MissouriMRDT/PowerManagement_Hardware/Docs/PMS Current Distrubution Diagram.png

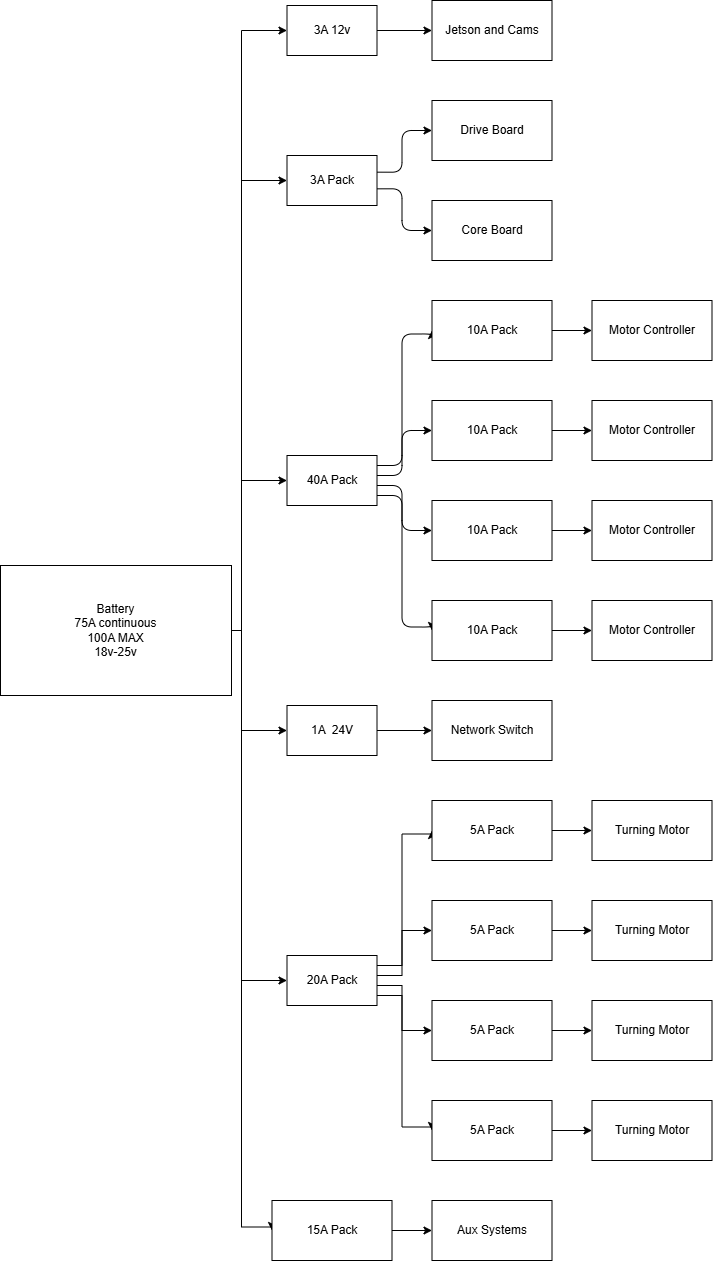
Docs/PMS Current Distrubution Diagram.png
