MissouriMRDT/PowerManagement_Hardware/PMS_board/PMS_board.kicad_pcb

## KiCad design PMS_board/PMS_board.kicad_pcb (2026-11-13)

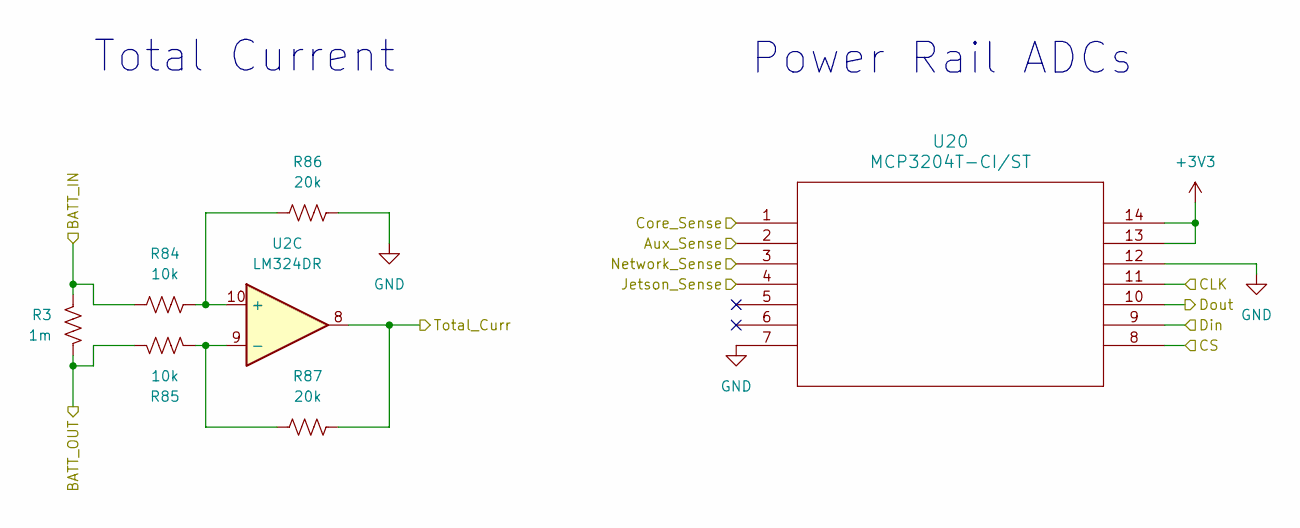
[picture p2: schematic CurrentSensing.kicad_sch]

Parts:
R3: 1m; ShuntSMD_BVT-M-R001-1.0
R84, R85: 10k; R_0603_1608Metric_Pad0.98x0.95mm_HandSolder
R86, R87: 20k; R_0603_1608Metric_Pad0.98x0.95mm_HandSolder
U2: LM324DR; SOIC-14_3.9x8.7mm_P1.27mm
U20: MCP3204T-CI/ST; TSSOP14_MC_MCH

Connections:
+3V3: U20.13, U20.14; also elsewhere on the board
/Current Sensing/Aux_Sense: U20.2; also elsewhere on the board
/Current Sensing/BATT_OUT: R3.2, R85.1; also elsewhere on the board
/Current Sensing/CLK: U20.11; also elsewhere on the board
/Current Sensing/CS: U20.8; also elsewhere on the board
/Current Sensing/Core_Sense: U20.1; also elsewhere on the board
/Current Sensing/Din: U20.9; also elsewhere on the board
/Current Sensing/Dout: U20.10; also elsewhere on the board
/Current Sensing/Jetson_Sense: U20.4; also elsewhere on the board
/Current Sensing/Network_Sense: U20.3; also elsewhere on the board
/Current Sensing/Total_Curr: R87.2, U2.8; also elsewhere on the board
/HotSwap/Aalmout: R3.1, R84.1; also elsewhere on the board
GND: R86.2, U20.7, U20.12; also elsewhere on the board
unnamed: R84.2, R86.1, U2.10 (+)
unnamed: R85.2, R87.1, U2.9 (-)

Notes on the sheet:
Total Current
Power Rail ADCs

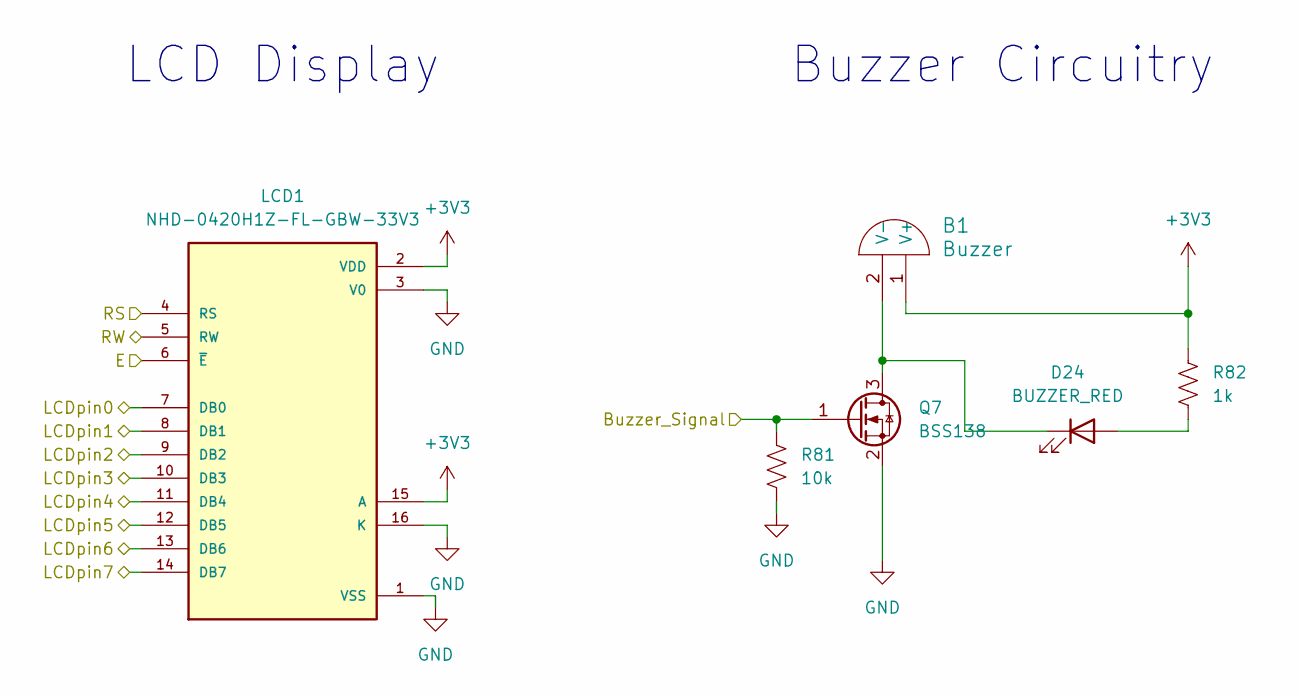
[picture p3: schematic Display.kicad_sch]

Parts:
B1: Buzzer; Buzzer_12x9.5RM7.6
D24: BUZZER_RED; LED_0603_1608Metric_Pad1.05x0.95mm_HandSolder
LCD1: NHD-0420H1Z-FL-GBW-33V3; LCD_NHD-0420H1Z-FL-GBW-33V3; PARTREV 02
Q7: BSS138; SOT-23
R81: 10k; R_0603_1608Metric_Pad0.98x0.95mm_HandSolder
R82: 1k; R_0603_1608Metric_Pad0.98x0.95mm_HandSolder

Connections:
+3V3: B1.1 (V+), LCD1.2 (VDD), LCD1.15 (A), R82.1; also elsewhere on the board
/Battery Display/Buzzer_Signal: Q7.1 (G), R81.1; also elsewhere on the board
/Battery Display/E: LCD1.6 (~E); also elsewhere on the board
/Battery Display/LCDpin0: LCD1.7 (DB0); also elsewhere on the board
/Battery Display/LCDpin1: LCD1.8 (DB1); also elsewhere on the board
/Battery Display/LCDpin2: LCD1.9 (DB2); also elsewhere on the board
/Battery Display/LCDpin3: LCD1.10 (DB3); also elsewhere on the board
/Battery Display/LCDpin4: LCD1.11 (DB4); also elsewhere on the board
/Battery Display/LCDpin5: LCD1.12 (DB5); also elsewhere on the board
/Battery Display/LCDpin6: LCD1.13 (DB6); also elsewhere on the board
/Battery Display/LCDpin7: LCD1.14 (DB7); also elsewhere on the board
/Battery Display/RS: LCD1.4 (RS); also elsewhere on the board
/Battery Display/RW: LCD1.5 (RW); also elsewhere on the board
GND: LCD1.1 (VSS), LCD1.3 (V0), LCD1.16 (K), Q7.2 (S), R81.2; also elsewhere on the board
unnamed: B1.2 (V-), D24.1 (K), Q7.3 (D)
unnamed: D24.2 (A), R82.2

Notes on the sheet:
Buzzer Circuitry
LCD Display

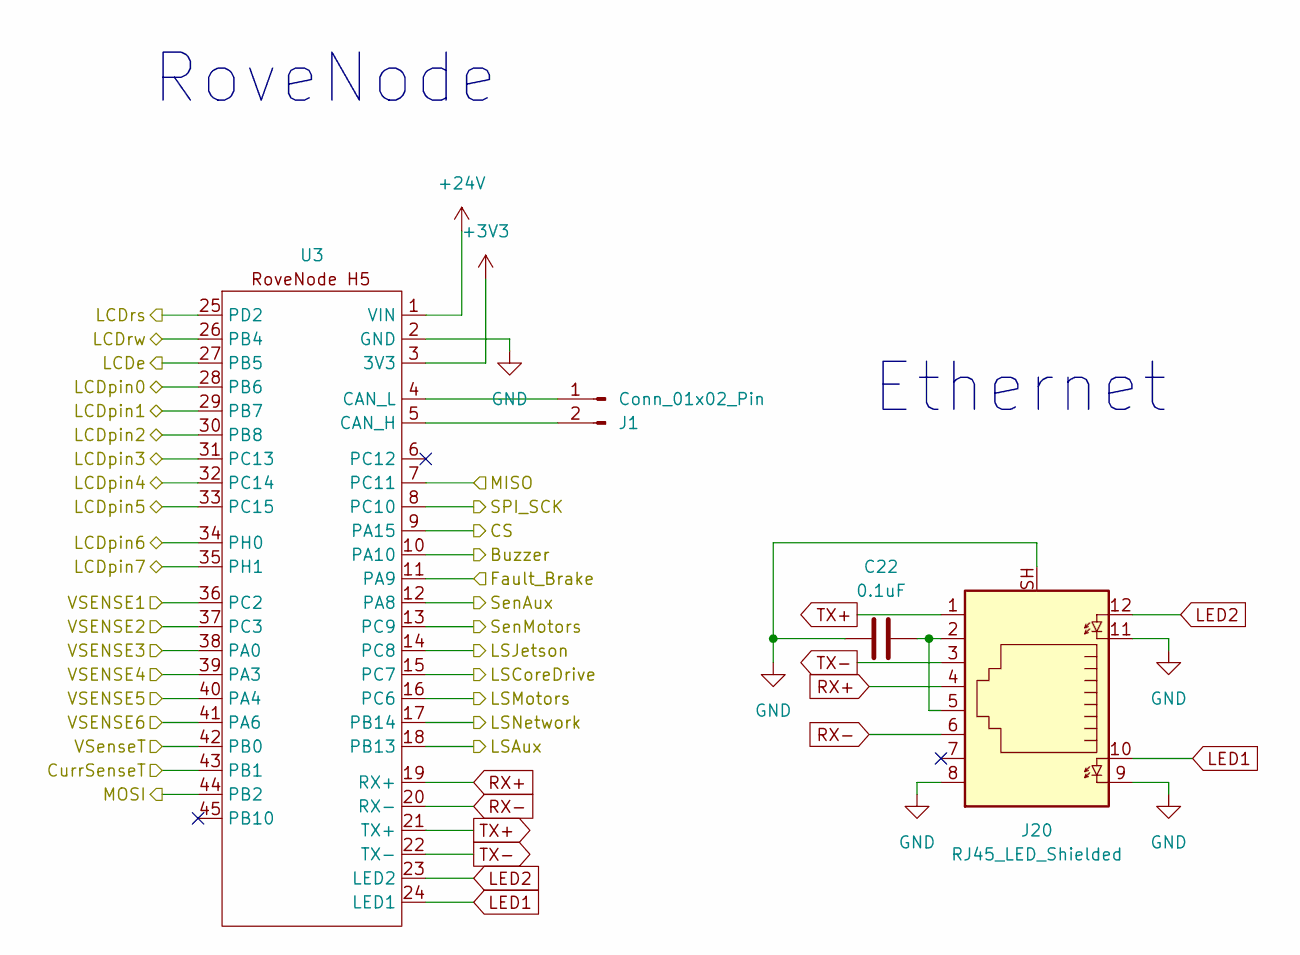
[picture p4: schematic MCU.kicad_sch]

Parts:
C22: 0.1uF; C_0603_1608Metric_Pad1.08x0.95mm_HandSolder
J1: Conn_01x02_Pin; JST_PH_B2B-PH-K_1x02_P2.00mm_Vertical
J20: RJ45_LED_Shielded; RJ45_Teensy
U3: RoveNode_H5

Connections:
+3V3: U3.3 (3V3); also elsewhere on the board
+24V: U3.1 (VIN); also elsewhere on the board
/Battery Display/Buzzer_Signal: U3.10 (PA10); also elsewhere on the board
/Battery Display/E: U3.27 (PB5); also elsewhere on the board
/Battery Display/LCDpin0: U3.28 (PB6); also elsewhere on the board
/Battery Display/LCDpin1: U3.29 (PB7); also elsewhere on the board
/Battery Display/LCDpin2: U3.30 (PB8); also elsewhere on the board
/Battery Display/LCDpin3: U3.31 (PC13); also elsewhere on the board
/Battery Display/LCDpin4: U3.32 (PC14); also elsewhere on the board
/Battery Display/LCDpin5: U3.33 (PC15); also elsewhere on the board
/Battery Display/LCDpin6: U3.34 (PH0); also elsewhere on the board
/Battery Display/LCDpin7: U3.35 (PH1); also elsewhere on the board
/Battery Display/RS: U3.25 (PD2); also elsewhere on the board
/Battery Display/RW: U3.26 (PB4); also elsewhere on the board
/Current Sensing/CLK: U3.8 (PC10); also elsewhere on the board
/Current Sensing/CS: U3.9 (PA15); also elsewhere on the board
/Current Sensing/Din: U3.44 (PB2); also elsewhere on the board
/Current Sensing/Dout: U3.7 (PC11); also elsewhere on the board
/Current Sensing/Total_Curr: U3.43 (PB1); also elsewhere on the board
/Load Switching + Outputs/Fault_Brakes: U3.11 (PA9); also elsewhere on the board
/Load Switching + Outputs/In_Aux: U3.18 (PB13); also elsewhere on the board
/Load Switching + Outputs/In_Boards: U3.15 (PC7); also elsewhere on the board
/Load Switching + Outputs/In_Jetson: U3.14 (PC8); also elsewhere on the board
/Load Switching + Outputs/In_Motors: U3.16 (PC6); also elsewhere on the board
/Load Switching + Outputs/In_Network: U3.17 (PB14); also elsewhere on the board
/Load Switching + Outputs/Sen_Aux: U3.12 (PA8); also elsewhere on the board
/Load Switching + Outputs/Sen_Motors: U3.13 (PC9); also elsewhere on the board
/Microcontroller/VSENSE1: U3.36 (PC2); also elsewhere on the board
/Microcontroller/VSENSE3: U3.38 (PA0); also elsewhere on the board
/Microcontroller/VSENSE4: U3.39 (PA3); also elsewhere on the board
/Microcontroller/VSENSE6: U3.41 (PA6); also elsewhere on the board
/Microcontroller/VSenseT: U3.42 (PB0); also elsewhere on the board
GND: C22.1, J20.8, J20.9, J20.11, J20.SH, U3.2 (GND); also elsewhere on the board
LED1: J20.10, U3.24 (LED1)
LED2: J20.12, U3.23 (LED2)
unnamed: C22.2, J20.2, J20.5
unnamed: J1.1, U3.4 (CAN_L)
unnamed: J1.2, U3.5 (CAN_H)
RX+: J20.4, U3.19 (RX+)
RX-: J20.6, U3.20 (RX-)
TX+: J20.1, U3.21 (TX+)
TX-: J20.3, U3.22 (TX-)

Notes on the sheet:
Ethernet
RoveNode

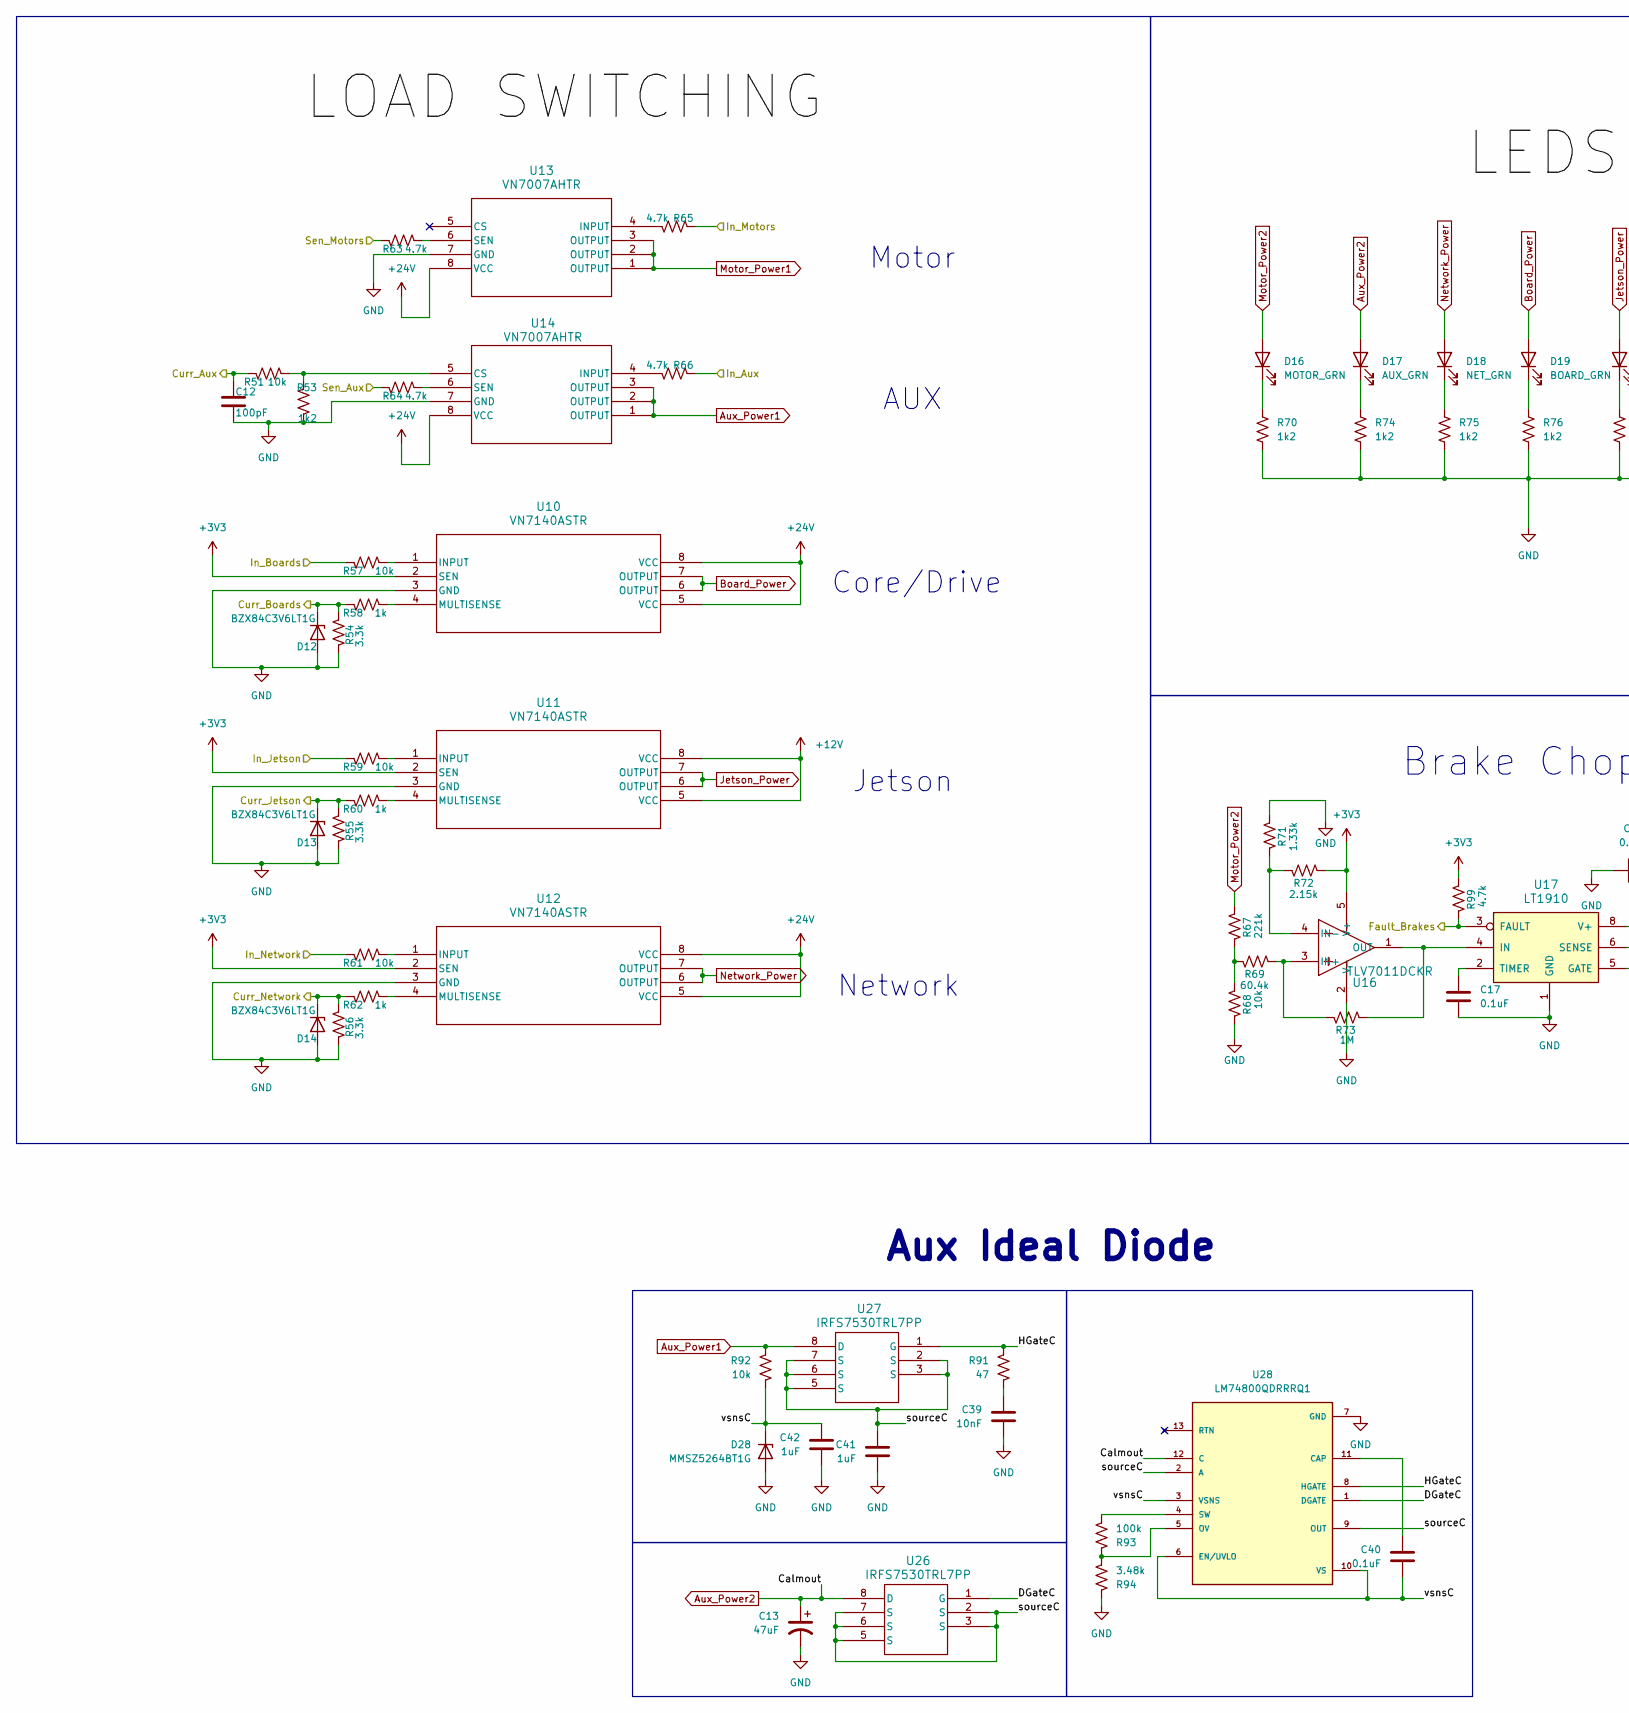
[picture p5: schematic Outputs.kicad_sch, part in row 1, column 1]

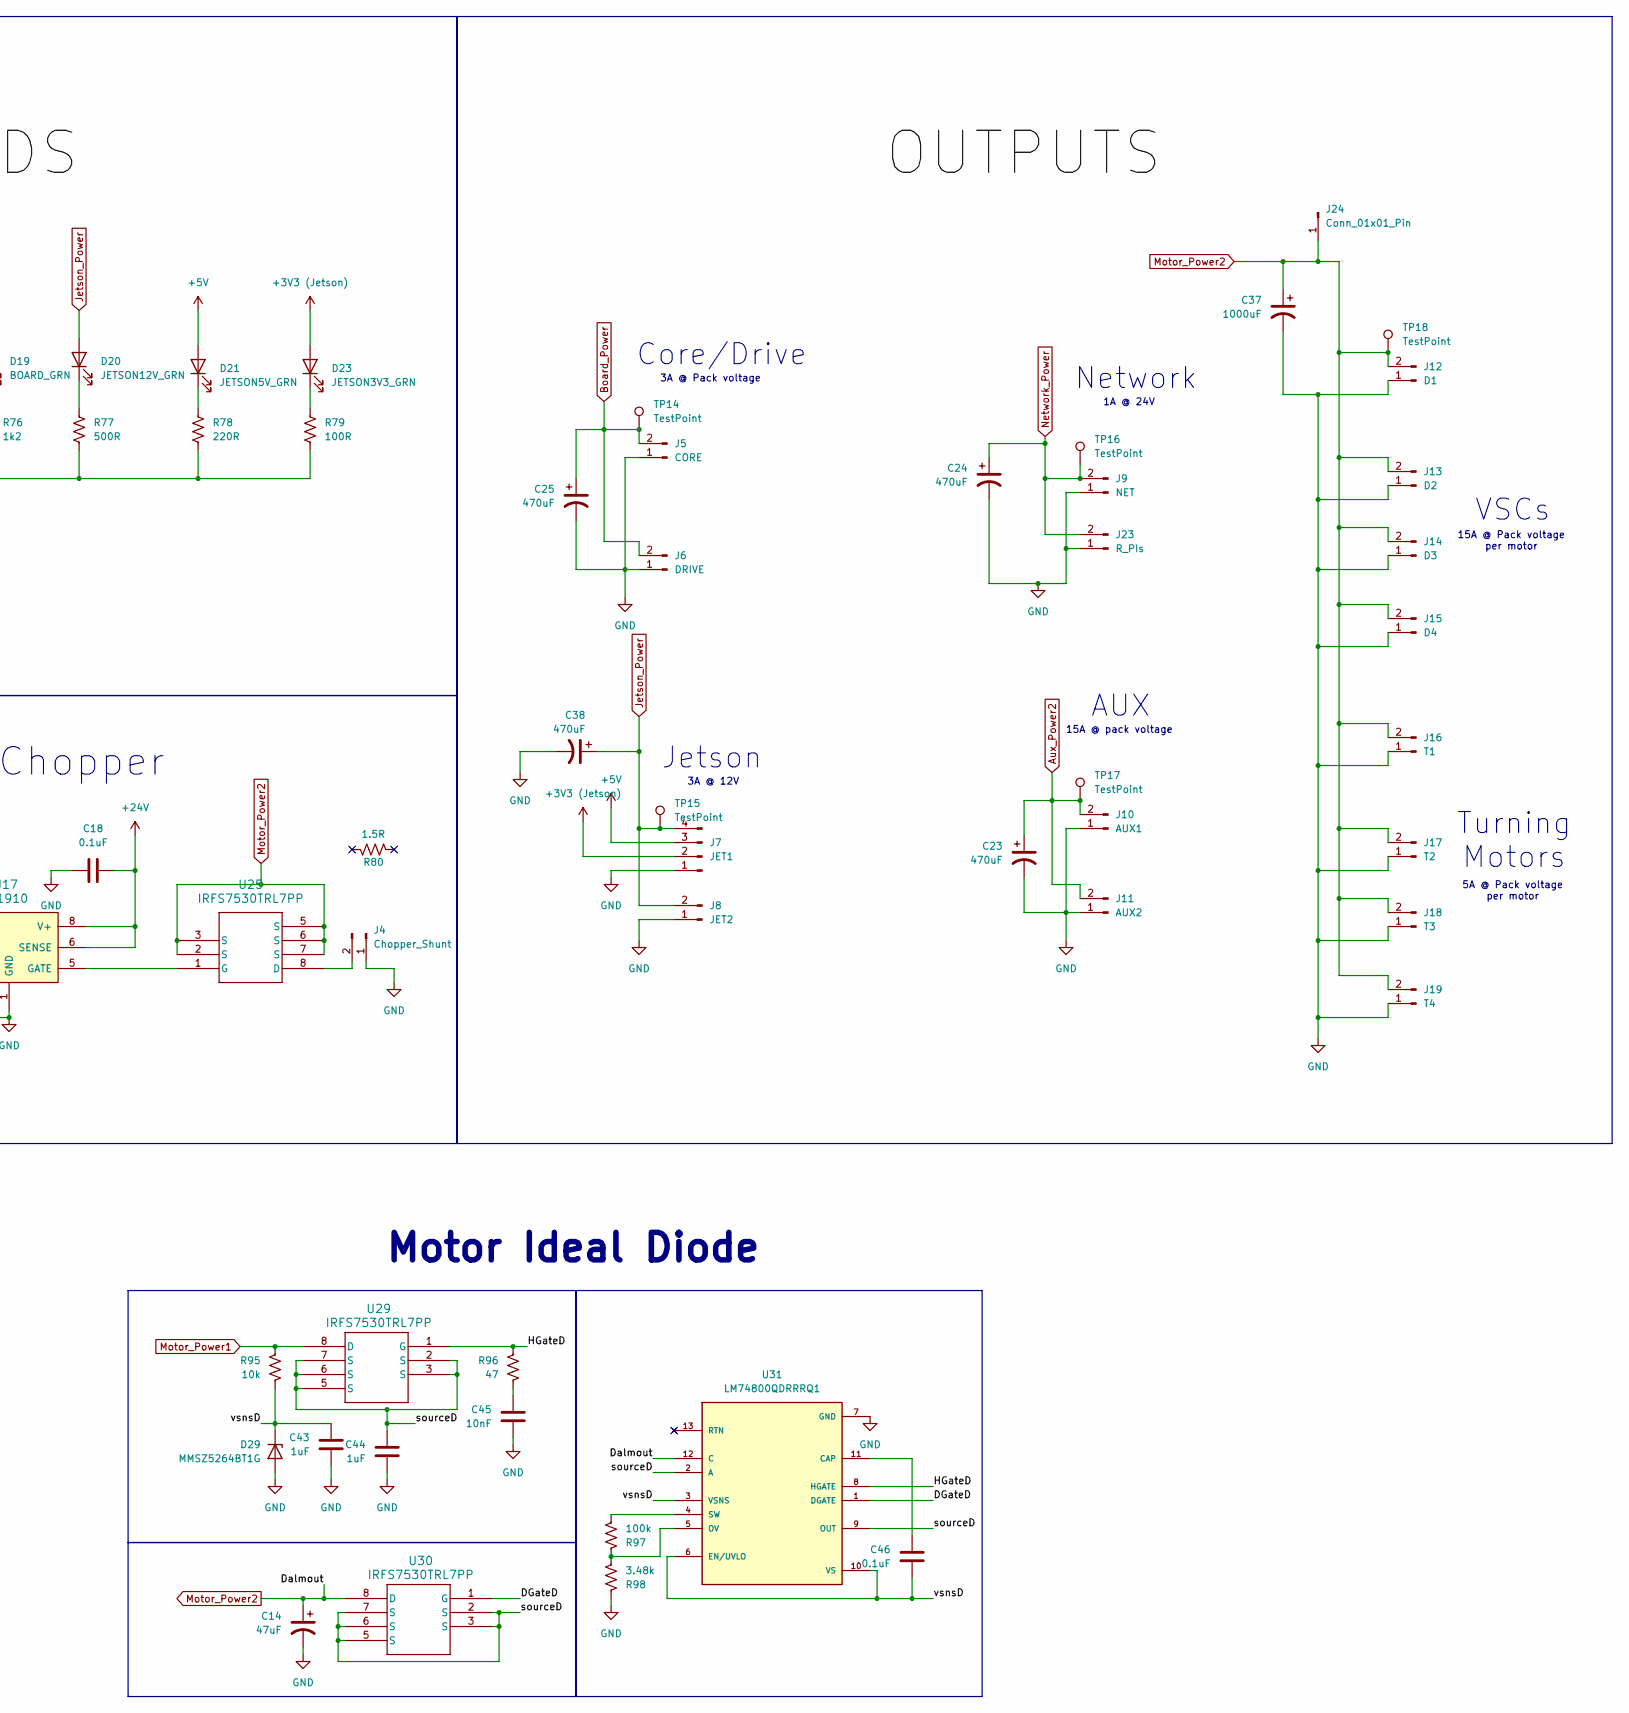
[picture p6: schematic Outputs.kicad_sch, part in row 1, column 2]

Parts:
C12: 100pF; C_0603_1608Metric_Pad1.08x0.95mm_HandSolder
C13, C14: 47uF; C_0603_1608Metric_Pad1.08x0.95mm_HandSolder
C17, C18, C40, C46: 0.1uF; C_0603_1608Metric_Pad1.08x0.95mm_HandSolder
C23, C24, C25, C38: 470uF; CP_Radial_D10.0mm_P5.00mm
C37: 1000uF; CP_Radial_D16.0mm_P7.50mm
C39, C45: 10nF; C_0603_1608Metric_Pad1.08x0.95mm_HandSolder
C41, C42, C43, C44: 1uF; C_0603_1608Metric_Pad1.08x0.95mm_HandSolder
D12, D13, D14: BZX84C3V6LT1G; SOT-23_Diode
D16: MOTOR_GRN; D_0603_1608Metric_Pad1.05x0.95mm_HandSolder
D17: AUX_GRN; D_0603_1608Metric_Pad1.05x0.95mm_HandSolder
D18: NET_GRN; D_0603_1608Metric_Pad1.05x0.95mm_HandSolder
D19: BOARD_GRN; D_0603_1608Metric_Pad1.05x0.95mm_HandSolder
D20: JETSON12V_GRN; D_0603_1608Metric_Pad1.05x0.95mm_HandSolder
D21: JETSON5V_GRN; D_0603_1608Metric_Pad1.05x0.95mm_HandSolder
D23: JETSON3V3_GRN; D_0603_1608Metric_Pad1.05x0.95mm_HandSolder
D28, D29: MMSZ5264BT1G; D_SOD-123
J4: Chopper_Shunt; MOLEX_MegaFit_02_Vertical
J5: CORE; MOLEX_MegaFit_02_Vertical
J6: DRIVE; MOLEX_MegaFit_02_Vertical
J7: JET1; MOLEX_SL_04_Vertical
J8: JET2; MOLEX_MegaFit_02_Vertical
J9: NET; MOLEX_MegaFit_02_Vertical
J10: AUX1; MOLEX_MegaFit_02_Vertical
J11: AUX2; MOLEX_MegaFit_02_Vertical
J12: D1; MOLEX_MegaFit_02_Vertical
J13: D2; MOLEX_MegaFit_02_Vertical
J14: D3; MOLEX_MegaFit_02_Vertical
J15: D4; MOLEX_MegaFit_02_Vertical
J16: T1; MOLEX_MegaFit_02_Vertical
J17: T2; MOLEX_MegaFit_02_Vertical
J18: T3; MOLEX_MegaFit_02_Vertical
J19: T4; MOLEX_MegaFit_02_Vertical
J23: R_PIs; MOLEX_MegaFit_02_Vertical
J24: Conn_01x01_Pin; Square_Anderson_1_V
R51, R57, R59, R61, R68, R92, R95: 10k; R_0603_1608Metric_Pad0.98x0.95mm_HandSolder
R53, R70, R74, R75, R76: 1k2; R_0603_1608Metric_Pad0.98x0.95mm_HandSolder
R54, R55, R56: 3.3k; R_0603_1608Metric_Pad0.98x0.95mm_HandSolder
R58, R60, R62: 1k; R_0603_1608Metric_Pad0.98x0.95mm_HandSolder
R63, R64, R65, R66, R99: 4.7k; R_0603_1608Metric_Pad0.98x0.95mm_HandSolder
R67: 221k; R_0603_1608Metric_Pad0.98x0.95mm_HandSolder
R69: 60.4k; R_0603_1608Metric_Pad0.98x0.95mm_HandSolder
R71: 1.33k; R_0603_1608Metric_Pad0.98x0.95mm_HandSolder
R72: 2.15k; R_0603_1608Metric_Pad0.98x0.95mm_HandSolder
R73: 1M; R_0603_1608Metric_Pad0.98x0.95mm_HandSolder
R77: 500R; R_0603_1608Metric_Pad0.98x0.95mm_HandSolder
R78: 220R; R_0603_1608Metric_Pad0.98x0.95mm_HandSolder
R79: 100R; R_0603_1608Metric_Pad0.98x0.95mm_HandSolder
R80: 1.5R
R91, R96: 47; R_0603_1608Metric_Pad0.98x0.95mm_HandSolder
R93, R97: 100k; R_0603_1608Metric_Pad0.98x0.95mm_HandSolder
R94, R98: 3.48k; R_0603_1608Metric_Pad0.98x0.95mm_HandSolder
TP14, TP15, TP16, TP17, TP18: TestPoint; TestPoint_Pad_D1.0mm
U10, U11, U12: VN7140ASTR; SO-8_STM
U13, U14: VN7007AHTR; OCTOPAK_STM
U16: TLV7011DCKR; DCK0005A_N
U17: LT1910; SO-8_3.9x4.9mm_P1.27mm
U25, U26, U27, U29, U30: IRFS7530TRL7PP; PG-TO263-7_INF
U28, U31: LM74800QDRRRQ1; IC_LM74800QDRRRQ1; PARTREV C

Connections:
+3V3: R72.2, R99.2, U10.2 (SEN), U11.2 (SEN), U12.2 (SEN), U16.5 (V+); also elsewhere on the board
+3V3 (Jetson): D23.2 (A), J7.2; also elsewhere on the board
+5V: D21.2 (A), J7.3; also elsewhere on the board
+12V: U11.5 (VCC), U11.8 (VCC); also elsewhere on the board
+24V: C18.2, U10.5 (VCC), U10.8 (VCC), U12.5 (VCC), U12.8 (VCC), U13.8 (VCC), U14.8 (VCC), U17.6 (SENSE), U17.8 (V+); also elsewhere on the board
/Current Sensing/Aux_Sense: C12.2, R51.2; also elsewhere on the board
/Current Sensing/Core_Sense: D12.1 (K), R54.2, R58.1; also elsewhere on the board
/Current Sensing/Jetson_Sense: D13.1 (K), R55.2, R60.1; also elsewhere on the board
/Current Sensing/Network_Sense: D14.1 (K), R56.2, R62.1; also elsewhere on the board
/Load Switching + Outputs/DGateC: U26.1 (G), U28.1 (DGATE)
/Load Switching + Outputs/DGateD: U30.1 (G), U31.1 (DGATE)
/Load Switching + Outputs/Fault_Brakes: R99.1, U17.3 (FAULT); also elsewhere on the board
/Load Switching + Outputs/HGateC: R91.1, U27.1 (G), U28.8 (HGATE)
/Load Switching + Outputs/HGateD: R96.1, U29.1 (G), U31.8 (HGATE)
/Load Switching + Outputs/In_Aux: R66.2; also elsewhere on the board
/Load Switching + Outputs/In_Boards: R57.1; also elsewhere on the board
/Load Switching + Outputs/In_Jetson: R59.1; also elsewhere on the board
/Load Switching + Outputs/In_Motors: R65.2; also elsewhere on the board
/Load Switching + Outputs/In_Network: R61.1; also elsewhere on the board
/Load Switching + Outputs/Sen_Aux: R64.2; also elsewhere on the board
/Load Switching + Outputs/Sen_Motors: R63.2; also elsewhere on the board
/Load Switching + Outputs/sourceC: C41.1, U26.2 (S), U26.3 (S), U26.5 (S), U26.6 (S), U26.7 (S), U27.2 (S), U27.3 (S), U27.5 (S), U27.6 (S), U27.7 (S), U28.2 (A), U28.9 (OUT)
/Load Switching + Outputs/sourceD: C44.1, U29.2 (S), U29.3 (S), U29.5 (S), U29.6 (S), U29.7 (S), U30.2 (S), U30.3 (S), U30.5 (S), U30.6 (S), U30.7 (S), U31.2 (A), U31.9 (OUT)
/Load Switching + Outputs/vsnsC: C40.2, C42.1, D28.1 (K), R92.1, U28.3 (VSNS), U28.6 (EN/UVLO), U28.10 (VS)
/Load Switching + Outputs/vsnsD: C43.1, C46.2, D29.1 (K), R95.1, U31.3 (VSNS), U31.6 (EN/UVLO), U31.10 (VS)
Aux_Power1: R92.2, U14.1 (OUTPUT), U14.2 (OUTPUT), U14.3 (OUTPUT), U27.8 (D)
Aux_Power2: C13.1, C23.1, D17.2 (A), J10.2, J11.2, TP17.1 (1_1), U26.8 (D), U28.12 (C)
Board_Power: C25.1, D19.2 (A), J5.2, J6.2, TP14.1 (1_1), U10.6 (OUTPUT), U10.7 (OUTPUT)
GND: C12.1, C13.2, C14.2, C17.2, C18.1, C23.2, C24.2, C25.2, C37.2, C38.2, C39.2, C41.2, C42.2, C43.2, C44.2, C45.2, D12.2 (A), D13.2 (A), D14.2 (A), D28.2 (A), D29.2 (A), J4.1, J5.1, J6.1, J7.1, J8.1, J9.1, J10.1, J11.1, J12.1, J13.1, J14.1, J15.1, J16.1, J17.1, J18.1, J19.1, J23.1, R53.2, R54.1, R55.1, R56.1, R68.1, R70.2, R71.2, R74.2, R75.2, R76.2, R77.2, R78.2, R79.2, R94.1, R98.1, U10.3 (GND), U11.3 (GND), U12.3 (GND), U13.7 (GND), U14.7 (GND), U16.2 (V-), U17.1 (GND), U28.7 (GND), U31.7 (GND); also elsewhere on the board
Jetson_Power: C38.1, D20.2 (A), J7.4, J8.2, TP15.1 (1_1), U11.6 (OUTPUT), U11.7 (OUTPUT)
Motor_Power1: R95.2, U13.1 (OUTPUT), U13.2 (OUTPUT), U13.3 (OUTPUT), U29.8 (D)
Motor_Power2: C14.1, C37.1, D16.2 (A), J12.2, J13.2, J14.2, J15.2, J16.2, J17.2, J18.2, J19.2, J24.1 (Pin_1_1), R67.2, TP18.1 (1_1), U25.2 (S), U25.3 (S), U25.5 (S), U25.6 (S), U25.7 (S), U30.8 (D), U31.12 (C)
unnamed: C39.1, R91.2
unnamed: C45.1, R96.2
unnamed: D16.1 (K), R70.1
unnamed: D17.1 (K), R74.1
unnamed: D18.1 (K), R75.1
unnamed: D19.1 (K), R76.1
unnamed: D20.1 (K), R77.1
unnamed: D21.1 (K), R78.1
unnamed: D23.1 (K), R79.1
unnamed: J4.2, U25.8 (D)
unnamed: R67.1, R68.2, R69.1
unnamed: R57.2, U10.1 (INPUT)
unnamed: R58.2, U10.4 (MULTISENSE)
unnamed: R59.2, U11.1 (INPUT)
unnamed: R60.2, U11.4 (MULTISENSE)
unnamed: R61.2, U12.1 (INPUT)
unnamed: R62.2, U12.4 (MULTISENSE)
unnamed: R65.1, U13.4 (INPUT)
unnamed: R63.1, U13.6 (SEN)
unnamed: R51.1, R53.1, U14.5 (CS)
unnamed: R66.1, U14.4 (INPUT)
unnamed: R64.1, U14.6 (SEN)
unnamed: R69.2, R73.1, U16.3 (IN+)
unnamed: R71.1, R72.1, U16.4 (IN-)
unnamed: R73.2, U16.1 (OUT), U17.4 (IN)
unnamed: U17.5 (GATE), U25.1 (G)
unnamed: C17.1, U17.2 (TIMER)
unnamed: C40.1, U28.11 (CAP)
unnamed: R93.1, R94.2, U28.5 (OV)
unnamed: R93.2, U28.4 (SW)
unnamed: C46.1, U31.11 (CAP)
unnamed: R97.1, R98.2, U31.5 (OV)
unnamed: R97.2, U31.4 (SW)
Network_Power: C24.1, D18.2 (A), J9.2, J23.2, TP16.1 (1_1), U12.6 (OUTPUT), U12.7 (OUTPUT)

Notes on the sheet:
Aux Ideal Diode
Jetson
15A @ Pack voltage per motor
Motor
Brake Chopper
AUX
Motor Ideal Diode
Core/Drive
Turning Motors
3A @ 12V
3A @ Pack voltage
Network
1A @ 24V
VSCs
Core/Drive
Jetson
5A @ Pack voltage per motor
15A @ pack voltage

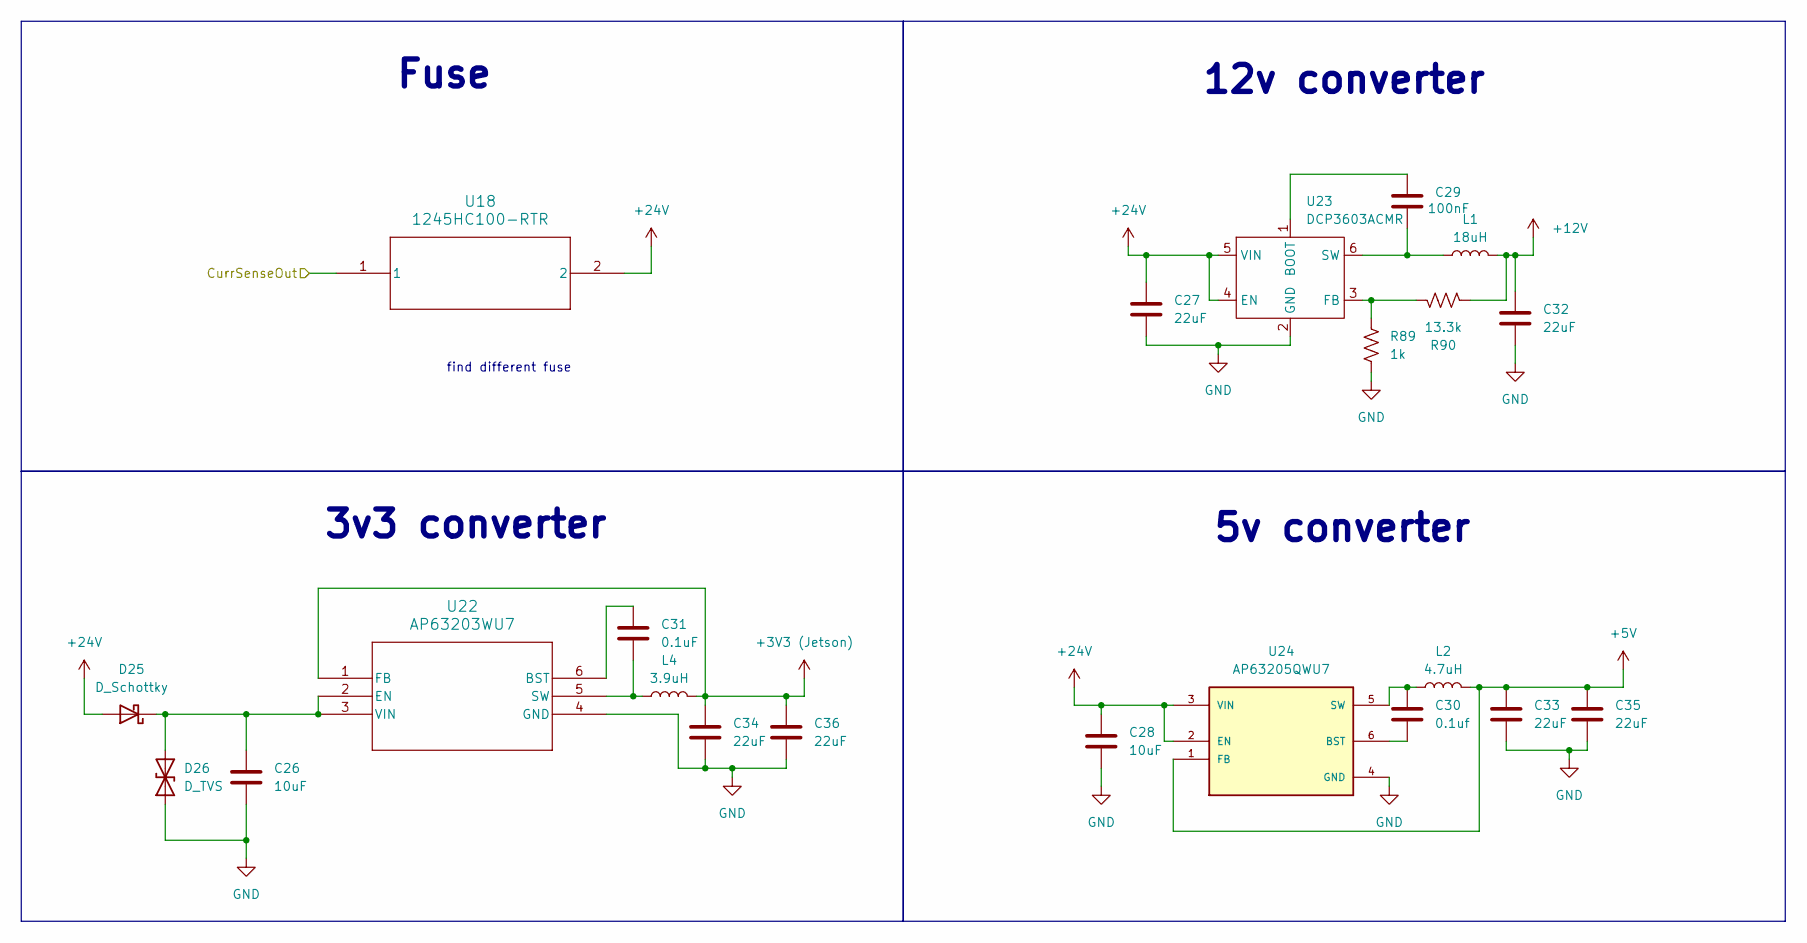
[picture p7: schematic SmoothingConversion.kicad_sch]

Parts:
C26, C28: 10uF; C_0603_1608Metric_Pad1.08x0.95mm_HandSolder
C27, C32, C33, C34, C35, C36: 22uF; C_0603_1608Metric_Pad1.08x0.95mm_HandSolder
C29: 100nF; C_0603_1608Metric_Pad1.08x0.95mm_HandSolder
C30: 0.1uf; C_0603_1608Metric_Pad1.08x0.95mm_HandSolder
C31: 0.1uF; C_0603_1608Metric_Pad1.08x0.95mm_HandSolder
D25: D_Schottky; D_SOD-123F
D26: D_TVS; D_Wurth_WE-TVSP-DO214-AC-400W_BI
L1: 18uH; IND_BOURNS_SRR1210
L2: 4.7uH; L_Bourns_SRR1210A
L4: 3.9uH; L_1812_4532Metric_Pad1.30x3.40mm_HandSolder
R89: 1k; R_0603_1608Metric_Pad0.98x0.95mm_HandSolder
R90: 13.3k; R_0603_1608Metric_Pad0.98x0.95mm_HandSolder
U18: 1245HC100-RTR; 1245HC100-RTR_COB
U22: AP63203WU7; SO8_DCK_TEX
U23: DCP3603ACMR; TSOT-23-6_HandSoldering
U24: AP63205QWU7; SOT95P280X100-6N; PARTREV 1 - 2; DigiKey_Part_Number 31-AP63205QWU-7CT-ND

Connections:
+3V3 (Jetson): C34.1, C36.1, L4.2, U22.1 (FB); also elsewhere on the board
+5V: C33.1, C35.1, L2.2, U24.1 (FB); also elsewhere on the board
+12V: C32.1, L1.2, R90.2; also elsewhere on the board
+24V: C27.1, C28.1, D25.2 (A), U18.2, U23.4 (EN), U23.5 (VIN), U24.2 (EN), U24.3 (VIN); also elsewhere on the board
/Current Sensing/BATT_OUT: U18.1; also elsewhere on the board
GND: C26.2, C27.2, C28.2, C32.2, C33.2, C34.2, C35.2, C36.2, D26.1 (A1), R89.2, U22.4 (GND), U23.2 (GND), U24.4 (GND); also elsewhere on the board
unnamed: C26.1, D25.1 (K), D26.2 (A2), U22.2 (EN), U22.3 (VIN)
unnamed: C31.1, U22.6 (BST)
unnamed: C31.2, L4.1, U22.5 (SW)
unnamed: C29.1, U23.1 (BOOT)
unnamed: R89.1, R90.1, U23.3 (FB)
unnamed: C29.2, L1.1, U23.6 (SW)
unnamed: C30.2, U24.6 (BST)
unnamed: C30.1, L2.1, U24.5 (SW)

Notes on the sheet:
Fuse
5v converter
3v3 converter
12v converter
find different fuse
