MissouriMRDT/PowerManagement_Hardware/PMS_board/PMS_board.kicad_pcb

## KiCad design PMS_board/PMS_board.kicad_pcb (continued)

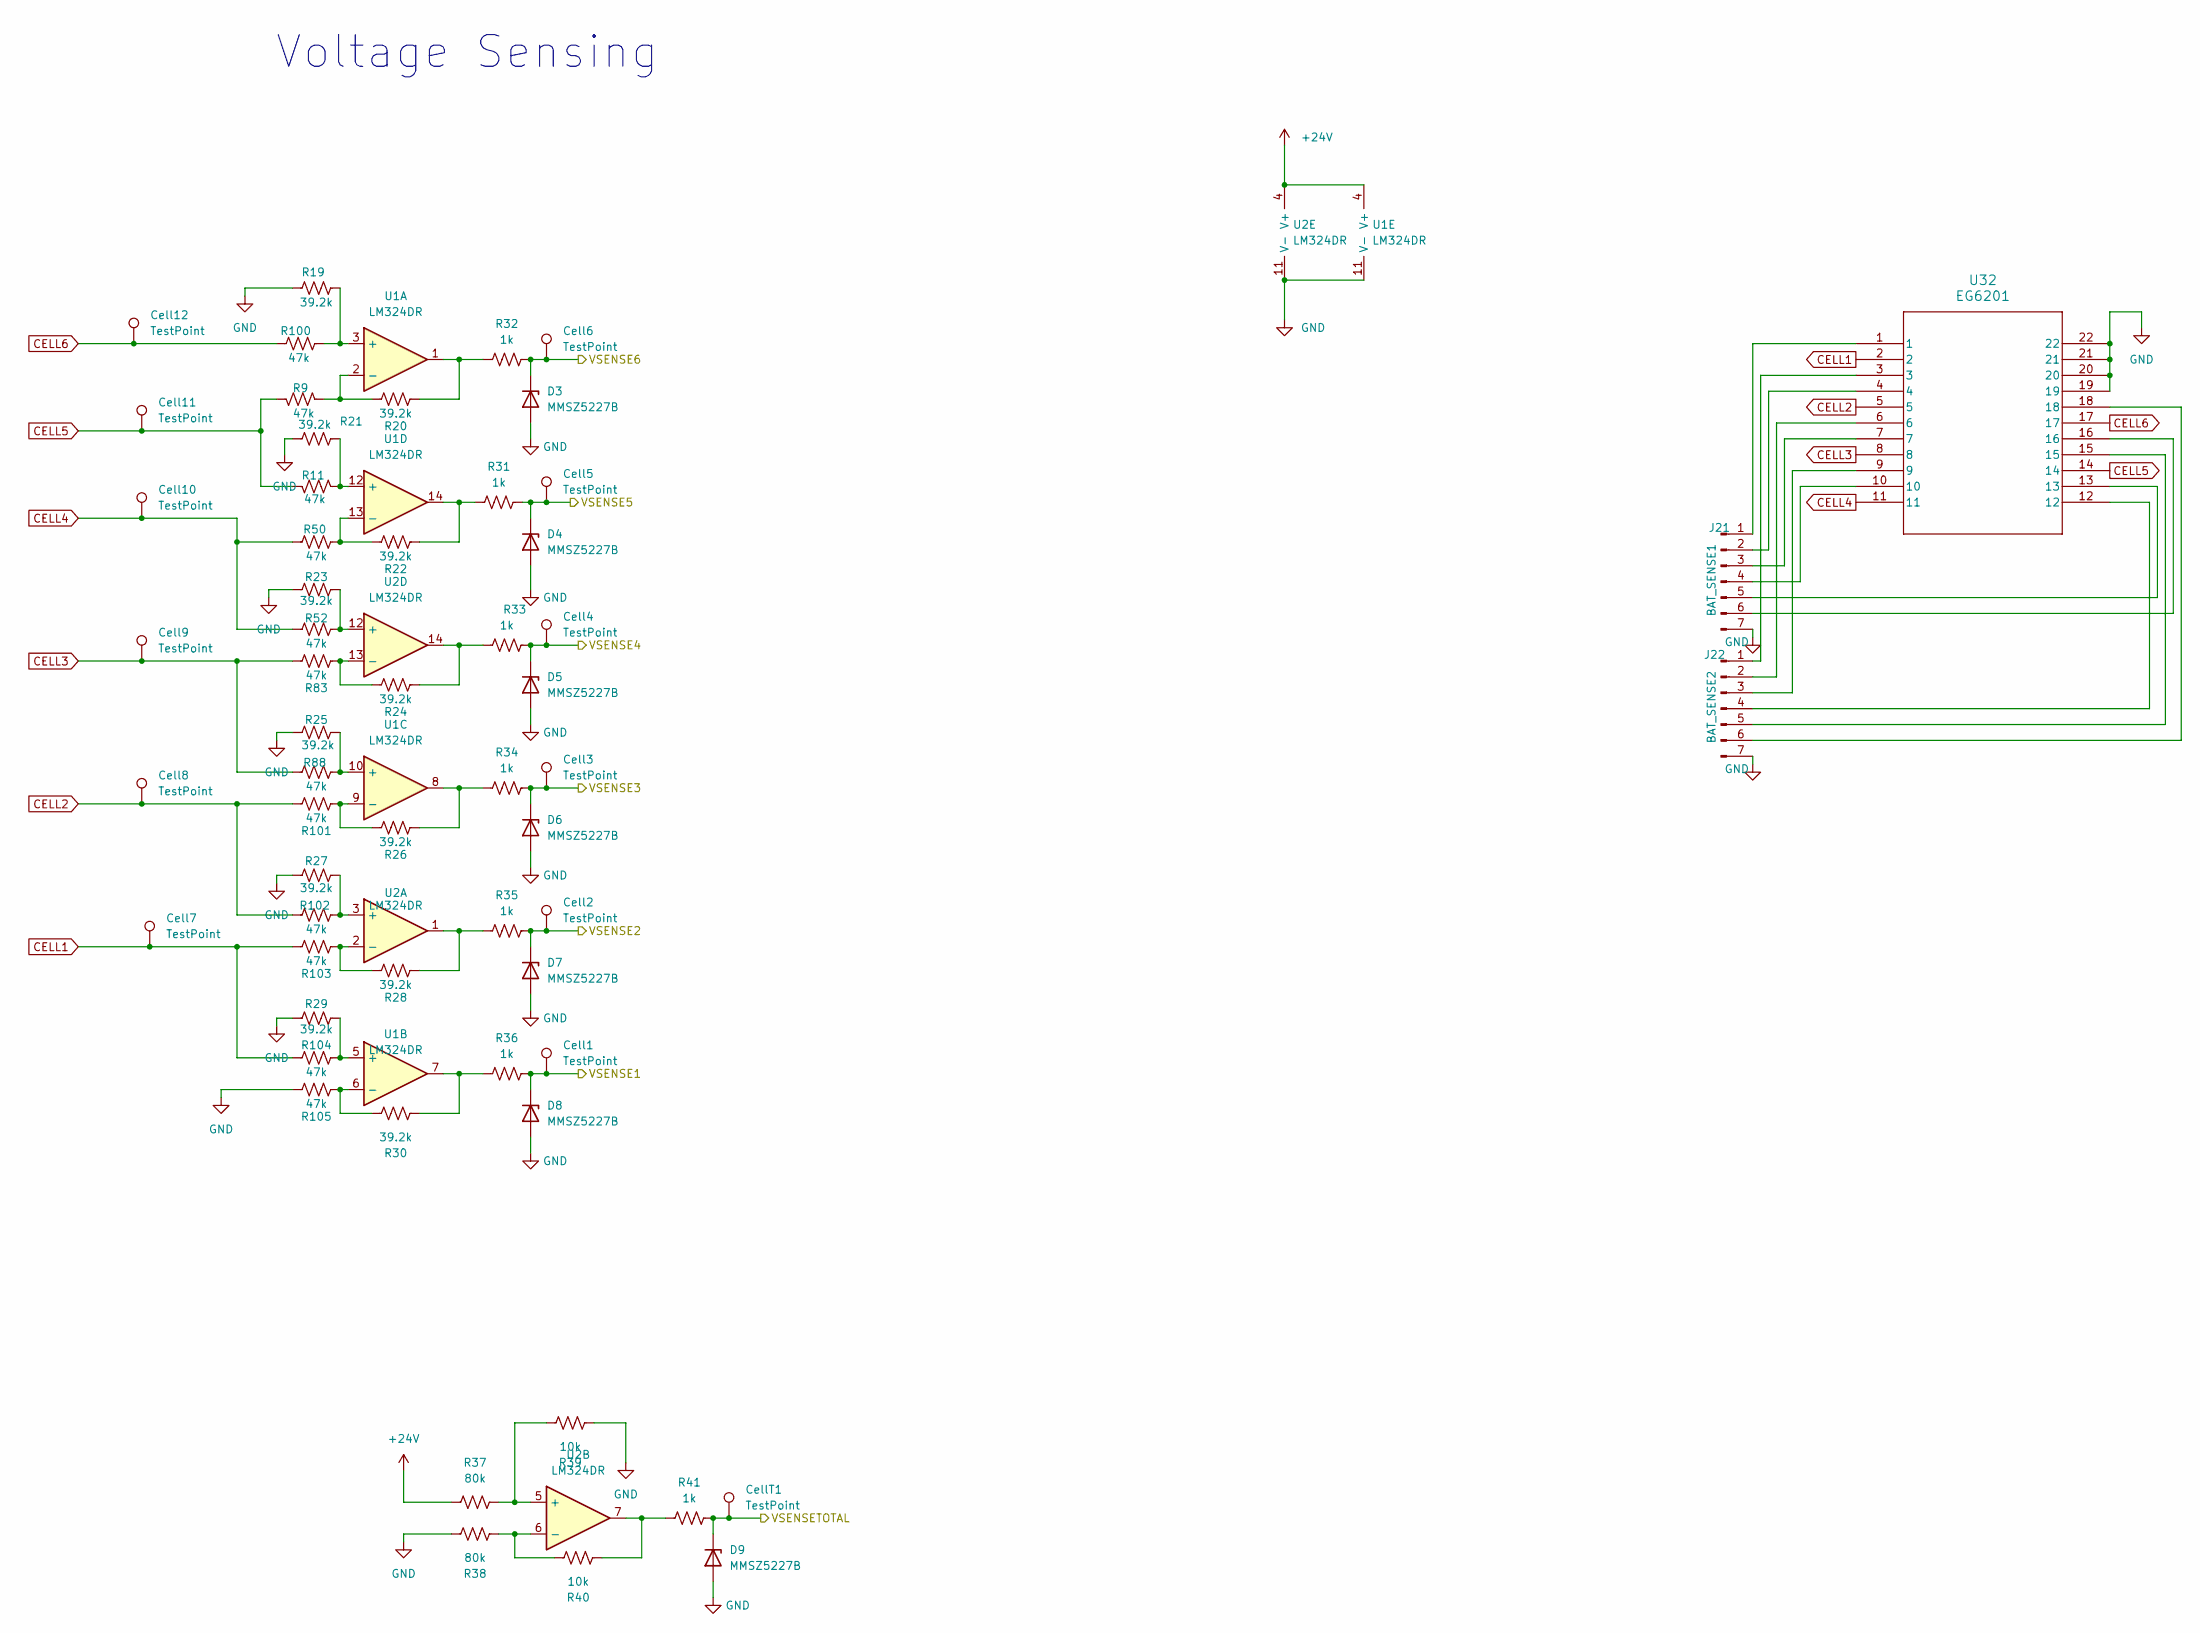
[picture p8: schematic VoltageSensing.kicad_sch]

Parts:
Cell1, Cell2, Cell3, Cell4, Cell5, Cell6, Cell7, Cell8, Cell9, Cell10, Cell11, Cell12: TestPoint; TestPoint_Pad_D1.0mm
CellT1: TestPoint; TestPoint_Pad_D1.0mm
D3, D4, D5, D6, D7, D8, D9: MMSZ5227B; D_SOD-123
J21: BAT_SENSE1; MOLEX_SL_07_Vertical
J22: BAT_SENSE2; MOLEX_SL_07_Vertical
R9, R11, R50, R52, R83, R88, R100, R101, R102, R103, R104, R105: 47k; R_0603_1608Metric_Pad0.98x0.95mm_HandSolder
R19, R20, R21, R22, R23, R24, R25, R26, R27, R28, R29, R30: 39.2k; R_0603_1608Metric_Pad0.98x0.95mm_HandSolder
R31, R32, R33, R34, R35, R36, R41: 1k; R_0603_1608Metric_Pad0.98x0.95mm_HandSolder
R37, R38: 80k; R_0603_1608Metric_Pad0.98x0.95mm_HandSolder
R39, R40: 10k; R_0603_1608Metric_Pad0.98x0.95mm_HandSolder
U1, U2: LM324DR; SOIC-14_3.9x8.7mm_P1.27mm
U32: EG6201; DIP_G6201_EWI

Connections:
+24V: R37.1, U1.4 (V+), U2.4 (V+); also elsewhere on the board
/Microcontroller/VSENSE1: Cell1.1 (1_1), D8.1 (K), R36.2; also elsewhere on the board
/Microcontroller/VSENSE3: Cell3.1 (1_1), D6.1 (K), R34.2; also elsewhere on the board
/Microcontroller/VSENSE4: Cell4.1 (1_1), D5.1 (K), R33.2; also elsewhere on the board
/Microcontroller/VSENSE6: Cell6.1 (1_1), D3.1 (K), R32.2; also elsewhere on the board
/Microcontroller/VSenseT: CellT1.1 (1_1), D9.1 (K), R41.2; also elsewhere on the board
CELL1: Cell7.1, R103.1, R104.1, U32.2; also elsewhere on the board
CELL3: Cell9.1, R83.1, R88.1, U32.8; also elsewhere on the board
CELL4: Cell10.1, R50.1, R52.1, U32.11; also elsewhere on the board
CELL6: Cell12.1, R100.1, U32.17; also elsewhere on the board
GND: D3.2 (A), D4.2 (A), D5.2 (A), D6.2 (A), D7.2 (A), D8.2 (A), D9.2 (A), J21.7, J22.7, R19.2, R21.2, R23.2, R25.2, R27.2, R29.2, R38.2, R39.2, R105.1, U1.11 (V-), U2.11 (V-), U32.19, U32.20, U32.21, U32.22; also elsewhere on the board
unnamed: J21.1, U32.1
unnamed: J21.2, U32.4
unnamed: J21.3, U32.7
unnamed: J21.4, U32.10
unnamed: J21.5, U32.13
unnamed: J21.6, U32.16
unnamed: J22.1, U32.3
unnamed: J22.2, U32.6
unnamed: J22.3, U32.9
unnamed: J22.4, U32.12
unnamed: J22.5, U32.15
unnamed: J22.6, U32.18
unnamed: R20.2, R32.1, U1.1
unnamed: R22.2, R31.1, U1.14
unnamed: R24.2, R33.1, U2.14
unnamed: R26.2, R34.1, U1.8
unnamed: R28.2, R35.1, U2.1
unnamed: R30.2, R36.1, U1.7
unnamed: R40.2, R41.1, U2.7
unnamed: R19.1, R100.2, U1.3 (+)
unnamed: R9.1, R20.1, U1.2 (-)
unnamed: R29.1, R104.2, U1.5 (+)
unnamed: R30.1, R105.2, U1.6 (-)
unnamed: R25.1, R88.2, U1.10 (+)
unnamed: R26.1, R101.2, U1.9 (-)
unnamed: R11.1, R21.1, U1.12 (+)
unnamed: R22.1, R50.2, U1.13 (-)
unnamed: R27.1, R102.2, U2.3 (+)
unnamed: R28.1, R103.2, U2.2 (-)
unnamed: R37.2, R39.1, U2.5 (+)
unnamed: R38.1, R40.1, U2.6 (-)
unnamed: R23.1, R52.2, U2.12 (+)
unnamed: R24.1, R83.2, U2.13 (-)

Notes on the sheet:
Voltage Sensing

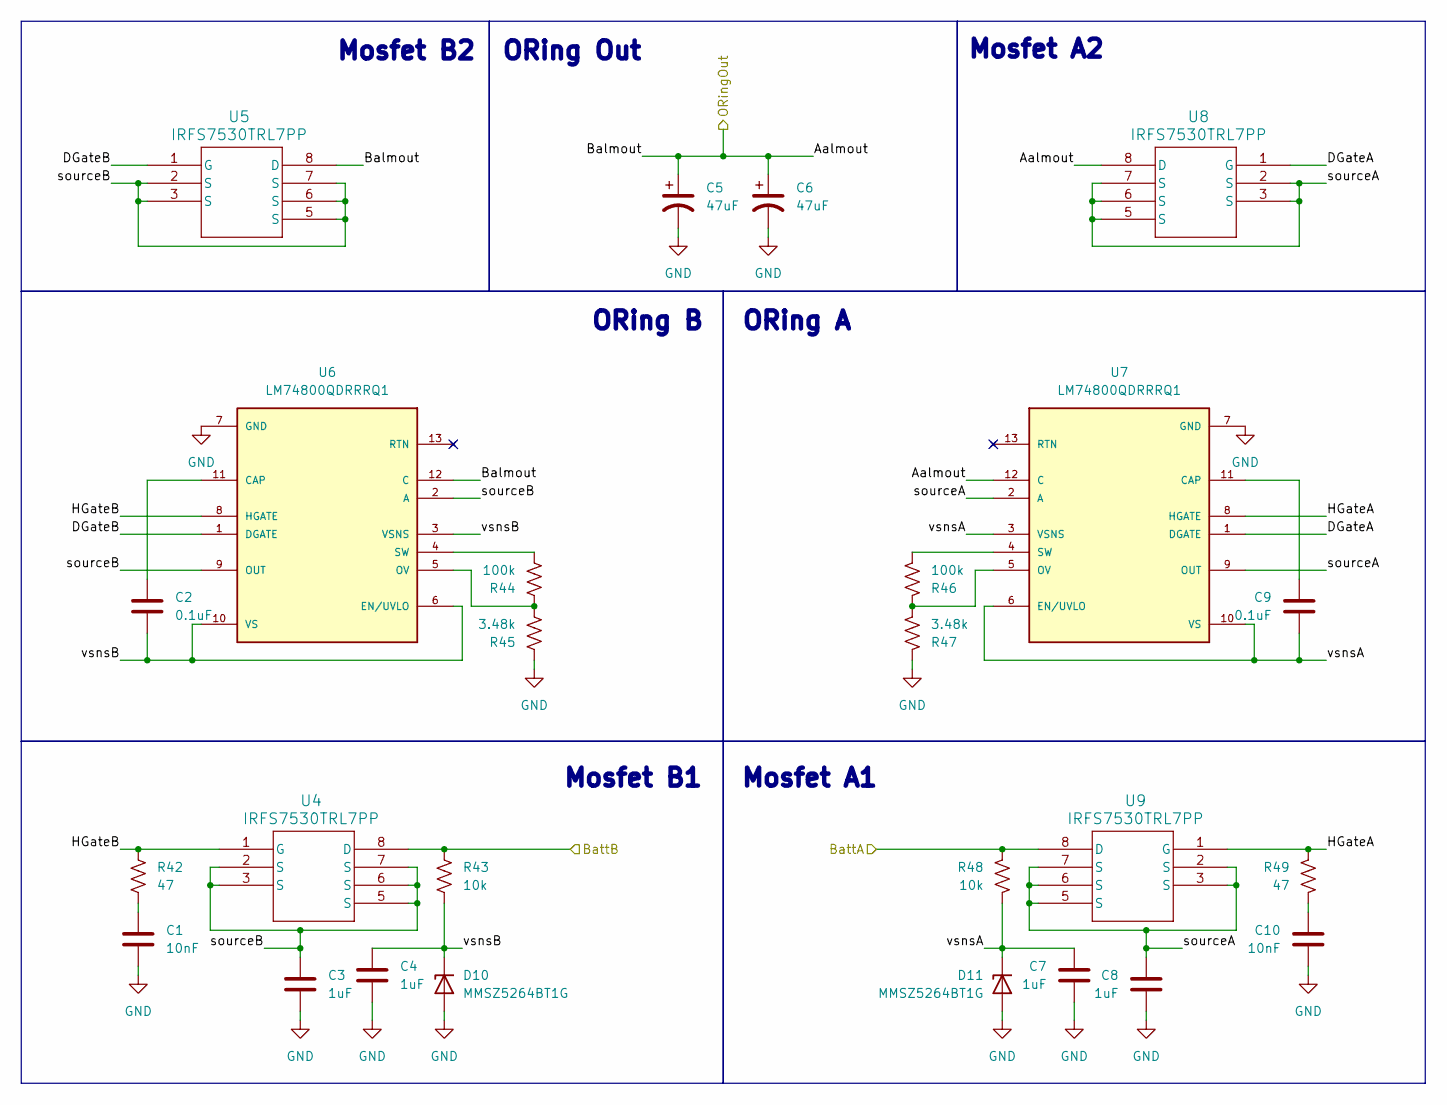
[picture p9: schematic hotswap.kicad_sch]

Parts:
C1, C10: 10nF; C_0603_1608Metric_Pad1.08x0.95mm_HandSolder
C2, C9: 0.1uF; C_0603_1608Metric_Pad1.08x0.95mm_HandSolder
C3, C4, C7, C8: 1uF; C_0603_1608Metric_Pad1.08x0.95mm_HandSolder
C5, C6: 47uF; C_0603_1608Metric_Pad1.08x0.95mm_HandSolder
D10, D11: MMSZ5264BT1G; D_SOD-123
R42, R49: 47; R_0603_1608Metric_Pad0.98x0.95mm_HandSolder
R43, R48: 10k; R_0603_1608Metric_Pad0.98x0.95mm_HandSolder
R44, R46: 100k; R_0603_1608Metric_Pad0.98x0.95mm_HandSolder
R45, R47: 3.48k; R_0603_1608Metric_Pad0.98x0.95mm_HandSolder
U4, U5, U8, U9: IRFS7530TRL7PP; PG-TO263-7_INF
U6, U7: LM74800QDRRRQ1; IC_LM74800QDRRRQ1; PARTREV C

Connections:
/HotSwap/Aalmout: C5.1, C6.1, U5.8 (D), U6.12 (C), U7.12 (C), U8.8 (D); also elsewhere on the board
/HotSwap/DGateA: U7.1 (DGATE), U8.1 (G)
/HotSwap/DGateB: U5.1 (G), U6.1 (DGATE)
/HotSwap/HGateA: R49.1, U7.8 (HGATE), U9.1 (G)
/HotSwap/HGateB: R42.1, U4.1 (G), U6.8 (HGATE)
/HotSwap/sourceA: C8.1, U7.2 (A), U7.9 (OUT), U8.2 (S), U8.3 (S), U8.5 (S), U8.6 (S), U8.7 (S), U9.2 (S), U9.3 (S), U9.5 (S), U9.6 (S), U9.7 (S)
/HotSwap/sourceB: C3.1, U4.2 (S), U4.3 (S), U4.5 (S), U4.6 (S), U4.7 (S), U5.2 (S), U5.3 (S), U5.5 (S), U5.6 (S), U5.7 (S), U6.2 (A), U6.9 (OUT)
/HotSwap/vsnsA: C7.1, C9.2, D11.1 (K), R48.1, U7.3 (VSNS), U7.6 (EN/UVLO), U7.10 (VS)
/HotSwap/vsnsB: C2.2, C4.1, D10.1 (K), R43.1, U6.3 (VSNS), U6.6 (EN/UVLO), U6.10 (VS)
BATTERY_IN1: R48.2, U9.8 (D); also elsewhere on the board
BATTERY_IN2: R43.2, U4.8 (D); also elsewhere on the board
GND: C1.2, C3.2, C4.2, C5.2, C6.2, C7.2, C8.2, C10.2, D10.2 (A), D11.2 (A), R45.1, R47.1, U6.7 (GND), U7.7 (GND); also elsewhere on the board
unnamed: C1.1, R42.2
unnamed: C10.1, R49.2
unnamed: C2.1, U6.11 (CAP)
unnamed: R44.1, R45.2, U6.5 (OV)
unnamed: R44.2, U6.4 (SW)
unnamed: C9.1, U7.11 (CAP)
unnamed: R46.1, R47.2, U7.5 (OV)
unnamed: R46.2, U7.4 (SW)

Notes on the sheet:
ORing B
ORing Out
Mosfet A1
Mosfet B1
ORing A
Mosfet A2
Mosfet B2

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
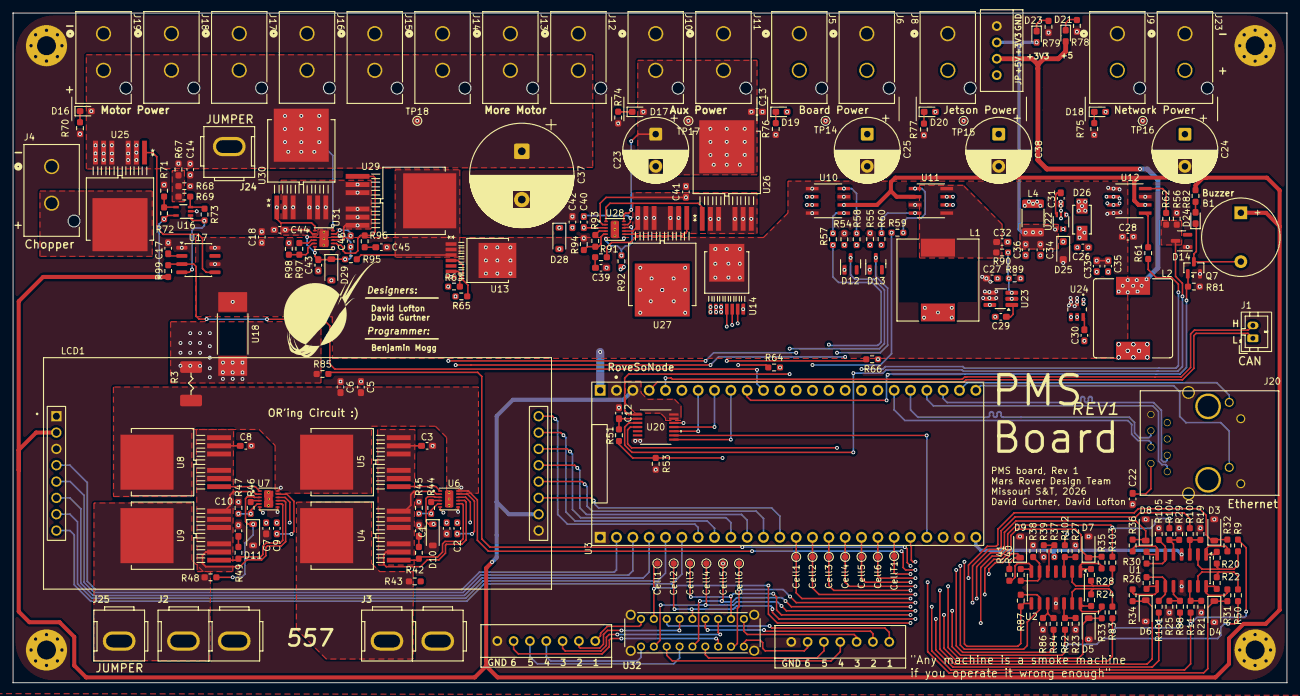
[picture p10: board PMS_board.kicad_pcb from above]

Board: 4 copper layers, 198.1 x 104.1 mm, 235 parts (0 on the bottom side), 170 nets.

Other parts of the board:
Cell1#2, Cell2#2, Cell3#2, Cell4#2, Cell5#2, Cell6#2: TestPoint; TestPoint_Pad_D1.0mm
H1, H2, H3, H4: MountingHole_Pad; 4_40_Hole_Pad_Via
J2, J3: Conn_01x02_Pin; Square_Anderson_2_V_Side_By_Side
J25: Conn_01x01_Pin; Square_Anderson_1_V

Their connections:
BATTERY_IN1: J2.2, J25.1 (Pin_1_1); also elsewhere on the board
BATTERY_IN2: J3.2; also elsewhere on the board
CELL1: Cell1#2.1 (1_1); also elsewhere on the board
CELL3: Cell3#2.1 (1_1); also elsewhere on the board
CELL4: Cell4#2.1 (1_1); also elsewhere on the board
CELL6: Cell6#2.1 (1_1); also elsewhere on the board
GND: H1.1 (1_1), H2.1 (1_1), H3.1 (1_1), H4.1 (1_1), J2.1, J3.1; also elsewhere on the board
