MissouriMRDT/PowerManagement_Hardware/(commit log)

2026-09-16 Initialize KiCAD project files
    [PMS_board.kicad_pcb, PMS_board.kicad_sch]
2026-09-26 Added a Battery Managment chip
    [BatteryManagement.kicad_sch, PMS_board.kicad_sch]
2026-09-26 add prep for hotswap
    [PMS_board.kicad_sch, hotswap.kicad_sch]
2026-09-27 adding lm7480, maybe
    [hotswap.kicad_sch]
2026-09-28 Small BMS fix
2026-09-28 Nuked L9962 :(
    [BatteryManagement.kicad_sch, PMS_board.kicad_sch]
2026-09-29 Voltage Sensing YIPPEEEEE
    [PMS_board.kicad_sch, VoltageSensing.kicad_sch]
2026-09-29 progress made :)
    [PMS_board.kicad_sch, hotswap.kicad_sch]
2026-09-29 Revert "Merge branch '2027_Rev1' of https://github.com/MissouriMRDT/PowerManagement_Hardware into 2027_Rev1"
    This reverts commit 58e8d8a37d7e6e053a99adaceb0a0b64a7e4d5ac, reversing
    changes made to 2dbcd4446407a5b00bde621a86c6c0759956a2a3.
    [BatteryManagement.kicad_sch, PMS_board.kicad_sch, VoltageSensing.kicad_sch]
2026-09-29 Revert "progress made :)"
    This reverts commit 2dbcd4446407a5b00bde621a86c6c0759956a2a3.
    [PMS_board.kicad_sch, hotswap.kicad_sch]
2026-09-29 Reapply "progress made :)"
    This reverts commit f9bb954494ca4d721f6975aec15efaba9a074564.
    [PMS_board.kicad_sch, hotswap.kicad_sch]
2026-09-29 Revert "Reapply "progress made :)""
    This reverts commit d1e2932f9c3cdbb21c2c39973e18eebc9d543e4e.
    [PMS_board.kicad_sch, hotswap.kicad_sch]
2026-09-29 Restored to stable commit
    Idk wtf i'm doing
    [BatteryManagement.kicad_sch, PMS_board.kicad_sch, VoltageSensing.kicad_sch]
2026-09-29 Restored Hotswap
    [hotswap.kicad_sch]
2026-09-30 making sure everything is good
    [VoltageSensing.kicad_sch, hotswap.kicad_sch]
2026-09-30 Added extra sheets
    [CurrentSensing.kicad_sch, Display.kicad_sch, MCU.kicad_sch, Outputs.kicad_sch, PMS_board.kicad_sch, hotswap.kicad_sch]
2026-09-30 Forgot one lmao
    [CurrentSensing.kicad_sch, MCU.kicad_sch, Outputs.kicad_sch, PMS_board.kicad_sch, SmoothingConversion.kicad_sch]
2026-10-01 Made a current diagram
2026-10-01 Added MIC5060 to lib and added 2nd relay
2026-10-01 worked on HotSwap
    [hotswap.kicad_sch]
2026-10-01 Added switching circuit for each power rail
    [Outputs.kicad_sch, PMS_board.kicad_sch]
2026-10-04 added buzzer? looked into stuff
    [Display.kicad_sch, MCU.kicad_sch, hotswap.kicad_sch]
2026-10-05 Lot of work on switching not yet done though
    [Outputs.kicad_sch, Rails.kicad_sch]
2026-10-05 Minor Format Update
    [Outputs.kicad_sch]
2026-10-06 Finished preliminary load switching circuit
    Except for the Aux
    [Outputs.kicad_sch, Rails.kicad_sch]
2026-10-06 Added Aux rail
    [Outputs.kicad_sch, Rails.kicad_sch]
2026-10-07 Added 3D model files to footprints
2026-10-08 Fix Hotswap
    I fixed hotswap, i think :)
    [MCU.kicad_sch, PMS_board.kicad_sch, hotswap.kicad_sch]
2026-10-08 add microcontroller pinout
    fixed hotswap, added pinouts to microcontroller, and made notes for power smoothing
    [MCU.kicad_sch, SmoothingConversion.kicad_sch, hotswap.kicad_sch]
2026-10-08 add datasheets
    I added links to the datasheets for the LCD and the ORing IC
    [Display.kicad_sch, hotswap.kicad_sch]
2026-10-08 add power smoothing
    I added the majority (i hope) of the necessary components for power smoothing and conversion. I also added notes to remind me and to inform others in my absence as to what still needs to be done to my knowledge.
    [SmoothingConversion.kicad_sch, hotswap.kicad_sch]
2026-10-09 add converter and friends
    I added the converter symbols and updated the schematic. I chose the proper FETs and Diodes for ORing circuit.
    [Display.kicad_sch, MCU.kicad_sch, SmoothingConversion.kicad_sch, hotswap.kicad_sch]
2026-10-10 Add Bucks & Fix Issues
    - Added 3V3 and 5V buck convertors
    - Removed Pi filter
    - adjusted capacitor values for Bulk Capacitors
    - Added inrush protection to ORing circuit
    - renamed various hierarchical pins for clarity
    - renamed power rail pins due to naming conflicts
    [Display.kicad_sch, SmoothingConversion.kicad_sch, hotswap.kicad_sch]
2026-10-10 Added Current Sensing
    [CurrentSensing.kicad_sch, Outputs.kicad_sch]
2026-10-10 Changed shunt resistor values to be more accurate
    [CurrentSensing.kicad_sch]
2026-10-11 Add Cell connectors
    [VoltageSensing.kicad_sch]
2026-10-11 Add Battery Connections & E-stop
    [PMS_board.kicad_sch]
2026-10-11 Cleaned up Output Sheet
    [Rails.kicad_sch]
2026-10-11 Swapped 3.3V in jeteson output rail with 3.3V (Jetson)
    [PMS_board.kicad_sch, Rails.kicad_sch, VoltageSensing.kicad_sch]
2026-10-11 Touch up Load Switch Circuit
    [Outputs.kicad_sch]
2026-10-11 Reformat main file & add battery inputs
    [PMS_board.kicad_sch]
2026-10-11 Added GND flags to Output rails and designated LEDs as green
2026-10-11 Added ADC for current sensing
2026-10-12 Added another Jetson connector and hierachal pins for JET+ and NET+
2026-10-12 Add Voltage Comparator for Brake Clamp
2026-10-12 Refine Current Sensing
    - Removed redundant current sensors
    - Fixed hierarchical labelling for sensors
    - added labeling for a few circuits
2026-10-13 Add reverse voltage protection
2026-10-13 Finish Schematic
    There's definitely stuff I missed, but I'm tired so we can review later. For my members to keep track of things, these are the changes/last minute additions I ran out of time to teach:
    - brake chopper circuitry & reverse voltage protection for aux & motor rails
    - microcontroller pinnouts
    - net connections between sheets
    - voltage resistors & system voltage measurements
    - cell sense connectors & switch
    - ADC routing
    Please Please PLEASE ask questions about these additions. I don't want you guys to feel like you don't own this schematic, and I'm sorry I had to take away some of these designs to finish early. I definitely left too much on your plate to get everything perfect, w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
2026-10-14 Add Footprints & such
    whoops forgot to push yesterday teehee
2026-10-17 Minor component tweaks and added a seperate LED sheet
    Changed component values
    Added labels
    Moved LEDs to it's own sheet
2026-10-17 Minor power changes and new buck for converting to 12V
    Changed supply voltage for 3V3 and 5V bucks from 24V to 12V
    Changed RoveNode supply from 24V to 12V
    Swapped old 12v LDO for buck
2026-10-17 Buck datasheet
2026-10-17 How did our footprints get this geeked???
2026-10-17 Footprints and naming things
    Changed component names to be a bit more representitive
    Some minor footprints
2026-10-19 New resistor values and more footprints
    LED footprints
    Changed resistor values as Drew requested
    Op amp datasheets and footprints
2026-10-19 add gate resistor
    added the 10k resistor to the mosfet gate in the buzzer
2026-10-19 Fixed footprints for load switch schotkeys
2026-10-22 Removed nesting in loadwsitching schematic
2026-10-22 Added current budgets for each output rail
2026-10-22 Changed relay out for PMOS power switching
2026-10-23 Fixed some broken footprints
2026-10-23 Zener Footprints
2026-10-23 New current sensor using old op amp
2026-10-23 Gave footprints to inductors
2026-10-23 fix Mosfet symbol
    fixed the mosfet symbol in outputs
2026-10-23 Add Fuse, made things look nice
    I added fuse symbol, footprint, and datasheet. I organized 2 sheets and condensed schematics
2026-10-23 Spec'ed TVSs and added more footprints
2026-10-23 Add TVS Footprint
    All diodes have footprints and data sheets as of right now.
2026-10-23 Fuse BAD
    change fuse
2026-10-24 Add pins to STM Chip
    I also changed chips for jetson and motor out.
2026-10-24 Fix resistor value
2026-10-26 Condensed Voltage Sensing circuit
2026-10-26 Footprints for connectors and new resistors
2026-10-27 Voltage Sensing and Capacitor Assign
2026-10-27 Add Zener
    Added zener diode data and footprints.
2026-10-28 readd mega fit footprint
2026-10-28 Layouted Voltage sensing + OR'ing circuit
2026-10-28 Fix Zener diodes
    current diode was speced with too low of a breakdown voltage. this has been fixed
2026-10-28 Aux Ideal diode *very* rough layout
2026-10-29 Change based on Will's input
    respeced buck
    swapped to molex_sls
    readded 6-pole switch
2026-10-29 Found Fuse
    We chose to stick with the old fuse
2026-10-30 Routed ORing circuit. (Please don't make me redo this)
2026-10-31 Routed AUX rail and Vsense
2026-11-01 Add 3D models & fix diodes
2026-11-01 Fixed trace width. Wired LCD
2026-11-01 Jetson Switch
2026-11-03 Gutted the board :(
2026-11-03 Gutted my board FR
2026-11-03 W board redesign
2026-11-04 Huge Progress
    did alot of work, mainly power and planes to figure out
2026-11-05 So Close
    almost there, power and planes SHOULD be the only things left, maybe slight placement refinement
2026-11-05 Got rid of DRC errors and wired GND and power planes
2026-11-05 Make all 10's!
    I rid the board of the infamous 7.82mil trace. I also cleared errors of net stuff
2026-11-06 Stitching and silkscreens
2026-11-06 More silkscreens (again)
2026-11-07 Add power resistor
2026-11-08 Board edges adjusted for screenshot
2026-11-09 trace and organize first quadrant
    the top-right quarter has been organized and traced. The main thing left is ideal diodes for motor and aux. After that will be silkscreen and further organization.
2026-11-09 Fixed unused motor current sensor
2026-11-09 Fix ORing
    fixed oring and 24V
2026-11-10 a single silkscreen :)
2026-11-11 Massive Progress
    prioritized Gates and Sources in the LM74800 chips. made power planes that were in the back include In.2. Moved traces and components that lie within the bounds of the 24V plane to not cut the 24V as much. I also began labeling with silkscreens. I have yet to label LED's, VIA Stitch, and need to ask drew dew about his gate source zener thingy.
2026-11-12 Minor fixes
    changes the layer of certain signal traces. added silkscreens for LED's, moved silkscreens for connectors aswell as fixed spacing, Added silkscreens for each pin on each connector. |...|
